PhobGCC/PhobGCCv2-HW/PCB/Models/PhobGCC_test.step

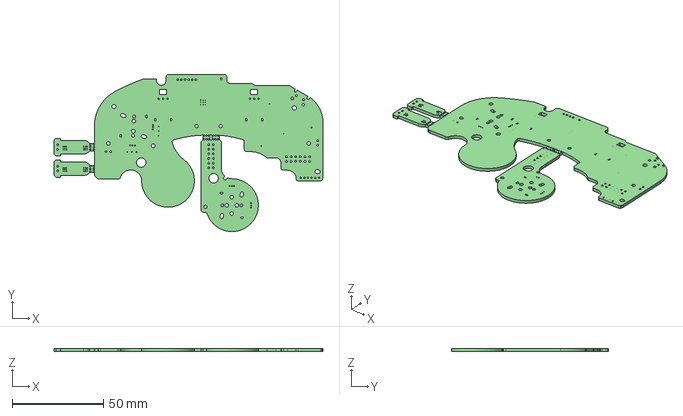
[picture p1: CAD file, 2022-11-16]
PCB/Models/PhobGCC_test.step
147.6 x 86.2 x 1.60 mm
