PhobGCC/PhobGCCv2-HW/PCB/Models/RP2040_QFN_PACKAGE.STEP

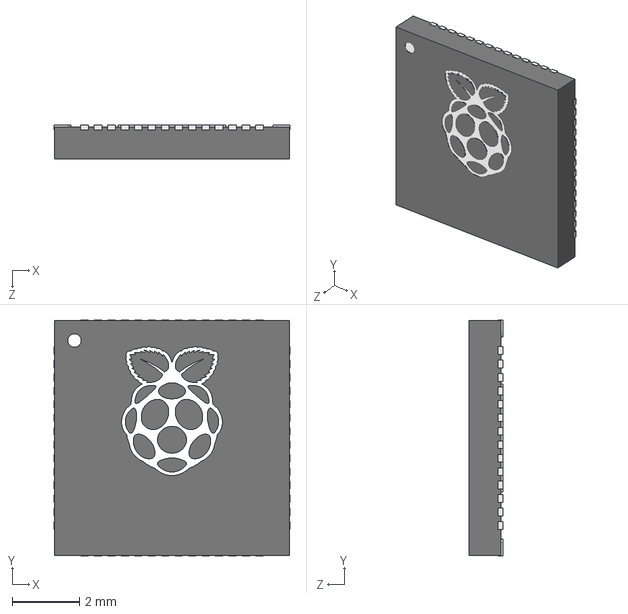
[picture p2: CAD file, 2022-11-16]
PCB/Models/RP2040_QFN_PACKAGE.STEP
7.02 x 7.02 x 1.00 mm
