PhobGCC/PhobGCCv2-HW/PCB/Models/FH34SRJ-12S-0.5SH.stp

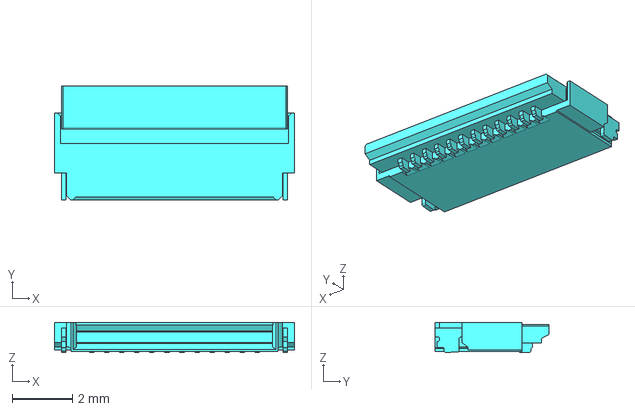
[picture p3: CAD file, 2022-11-16]
PCB/Models/FH34SRJ-12S-0.5SH.stp
8.00 x 3.80 x 1.00 mm
