PhobGCC/PhobGCCv2-HW/PCB/Models/SOIC_128JVSIQ_WIN.step

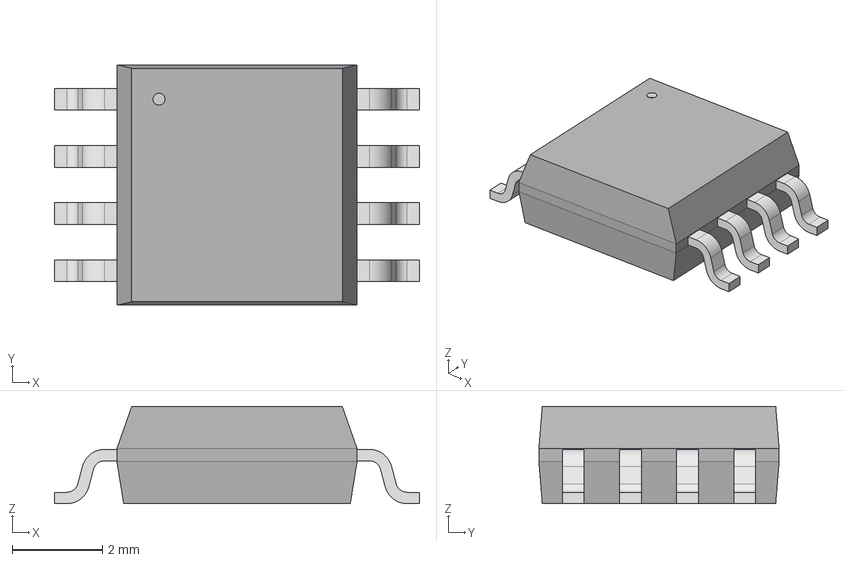
[picture p4: CAD file, 2022-11-16]
PCB/Models/SOIC_128JVSIQ_WIN.step
8.10 x 5.33 x 2.16 mm
