PhobGCC/PhobGCCv2-HW/PCB/Models/TS-1187A-B-A-B--3DModel-STEP-56544.STEP

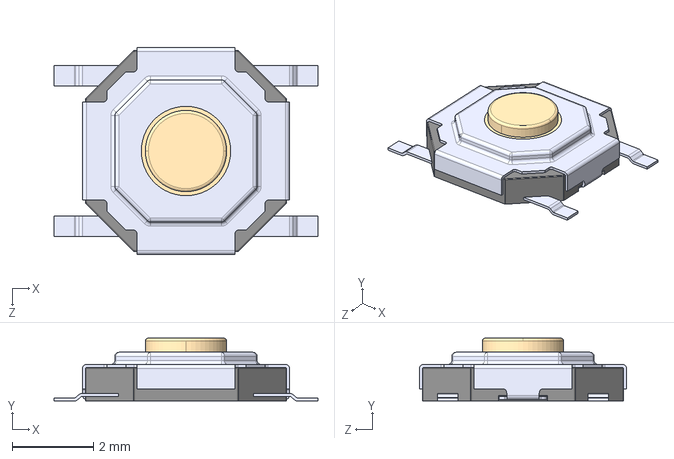
[picture p5: CAD file, 2022-11-16]
PCB/Models/TS-1187A-B-A-B--3DModel-STEP-56544.STEP
6.50 x 1.55 x 5.10 mm
