PhobGCC/PhobGCCv2-HW/PCB/Models/10118194c.stp

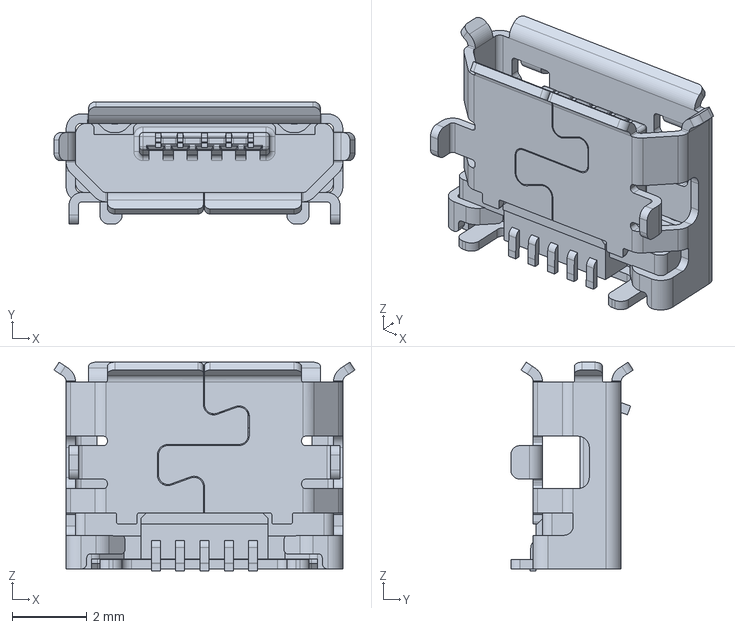
[picture p6: CAD file, 2022-11-16]
PCB/Models/10118194c.stp
8.05 x 3.27 x 5.58 mm
