PhobGCC/PhobGCCv2-HW/(list of files, cad)

Other CAD files:
PCB/Models/10118194C.igs
PCB/Models/FH34SRJ-12S-0.5SH.igs
