PhobGCC/PhobGCCv2-HW/(commit log)

2022-11-16 Initial PhobGCC v2.0 Commit
    [10118194C.igs, 10118194c.stp, FH34SRJ-12S-0.5SH.igs, FH34SRJ-12S-0.5SH.stp, PhobGCC_2_0_0_proto_1.kicad_pcb, PhobGCC_2_0_0_proto_1.kicad_sch, PhobGCC_test.step, RP2040_QFN_PACKAGE.STEP]
2022-12-08 expand clearance between pads and fill
    [PhobGCC_2_0_0_proto_1.kicad_pcb]
2022-12-11 functional changes for 2.0.1
    [PhobGCC_2_0_0_proto_1.kicad_pcb, PhobGCC_2_0_0_proto_1.kicad_sch]
2022-12-11 z changes (u shaped, elongation) and small cleanup
    [PhobGCC_2_0_0_proto_1.kicad_pcb, PhobGCC_2_0_0_proto_1.kicad_sch]
2022-12-11 silkscreen and other small changes
    [PhobGCC_2_0_0_proto_1.kicad_pcb]
2022-12-11 remove phobvision ghost
    [PhobGCC_2_0_0_proto_1.kicad_pcb]
2022-12-12 2.0.2 changes
    [PhobGCC_2_0_0_proto_1.kicad_pcb]
2022-12-12 move phobvision text
    [PhobGCC_2_0_0_proto_1.kicad_pcb]
2022-12-12 move backside ghost
    [PhobGCC_2_0_0_proto_1.kicad_pcb]
2022-12-14 dpad button footprint elongation
    [PhobGCC_2_0_0_proto_1.kicad_pcb]
2022-12-20 starting pad changes for 2.0.3
    [PhobGCC_2_0_0_proto_1.kicad_pcb, PhobGCC_2_0_0_proto_1.kicad_sch]
2022-12-20 add trigger paddles
    [TriggerBoard.kicad_pcb, TriggerBoard.kicad_sch]
2022-12-21 add keepout rule to dpad
    [PhobGCC_2_0_0_proto_1.kicad_pcb]
2022-12-22 add base triggerboard
    [TriggerBoard.kicad_pcb, TriggerBoard.kicad_sch]
2022-12-22 spiky trigger paddles
    [TriggerBoard.kicad_pcb]
2022-12-22 add footprints for trigger pads
2022-12-22 remove unneeded layers in trigger paddles
    [PhobGCC_2_0_0_proto_1.kicad_pcb, TriggerBoard.kicad_pcb]
2022-12-23 rotate z jst and lengthen c board breakaway for z jst clearance
    [PhobGCC_2_0_0_proto_1.kicad_pcb, TriggerBoard.kicad_pcb]
2023-01-12 abxy pad changes
    [PhobGCC_2_0_0_proto_1.kicad_pcb, PhobGCC_2_0_0_proto_1.kicad_sch]
2023-01-12 trigger board silkscreen update
    [TriggerBoard.kicad_pcb]
2023-01-12 rotate c stick logo
    [PhobGCC_2_0_0_proto_1.kicad_pcb]
2023-01-14 abxy pad center line thicker, round out dpad arch
    [PhobGCC_2_0_0_proto_1.kicad_pcb]
2023-01-14 'blue wire on left for oem cables'
    [PhobGCC_2_0_0_proto_1.kicad_pcb]
2023-01-14 oly u usb data pin position
    [PhobGCC_2_0_0_proto_1.kicad_pcb]
2023-01-14 ground track coverage
    [PhobGCC_2_0_0_proto_1.kicad_pcb]
2023-01-16 fix oly u by 1mm
    [PhobGCC_2_0_0_proto_1.kicad_pcb]
2023-01-16 actually line up olyu for real (for real)
    [PhobGCC_2_0_0_proto_1.kicad_pcb]
2023-01-20 move L pads for JST clearance
    [PhobGCC_2_0_0_proto_1.kicad_pcb]
2023-01-25 keepout around cstick header
    [PhobGCC_2_0_0_proto_1.kicad_pcb]
2023-01-25 bigger keepout around cstick header
    [PhobGCC_2_0_0_proto_1.kicad_pcb]
2023-02-11 ESD protection
    Added 100k resistor between sgnd and gnd of usb connector
    Added USBLC6 to protect USB data lines
    Added TVS diodes to GCD and 3.3 lines
    Added 47uF bulk capacitor
    [PhobGCC_2_0_0_proto_1.kicad_pcb, PhobGCC_2_0_0_proto_1.kicad_sch]
2023-02-13 Isolate 47uF capacitor
    Isolates the 47uF capacitor with a diode. Matches the voltage drop so there is a consistent power level across USB or GC cable. Prevents inrush current on USB power.
    [PhobGCC_2_0_0_proto_1.kicad_pcb, PhobGCC_2_0_0_proto_1.kicad_sch]
2023-02-13 Inset components to account for rib
    [PhobGCC_2_0_0_proto_1.kicad_pcb]
2023-02-15 Move C16 in 1mm
    [PhobGCC_2_0_0_proto_1.kicad_pcb]
2023-02-15 move 3.3v cap inboard of schottky
    [PhobGCC_2_0_0_proto_1.kicad_pcb, PhobGCC_2_0_0_proto_1.kicad_sch]
2023-02-15 small aesthetic tweak to traces
    [PhobGCC_2_0_0_proto_1.kicad_pcb]
2023-02-16 reduce paste applied to rp2040 pins
    [PhobGCC_2_0_0_proto_1.kicad_pcb]
2023-02-24 fix DRC and silkscreen
    [PhobGCC_2_0_0_proto_1.kicad_pcb]
2023-02-25 remove rando silkscreen line
    [PhobGCC_2_0_0_proto_1.kicad_pcb]
2023-02-27 make z jumper not go through z button trace
    [PhobGCC_2_0_0_proto_1.kicad_pcb]
2023-02-27 make z jumper not go through z button trace (for real)
    [PhobGCC_2_0_0_proto_1.kicad_pcb]
2023-03-18 solder pad absolute clearance back to 0
    [PhobGCC_2_0_0_proto_1.kicad_pcb]
2023-03-18 thick olyu usb lines, 2.0.4 version
    [PhobGCC_2_0_0_proto_1.kicad_pcb]
2023-04-01 replace discrete diodes with usblc6
    [PhobGCC_2_0_0_proto_1.kicad_pcb, PhobGCC_2_0_0_proto_1.kicad_sch]
2023-04-01 add lcsc part numbers
    [PhobGCC_2_0_0_proto_1.kicad_sch]
2023-04-01 minor tweaking of routing
    [PhobGCC_2_0_0_proto_1.kicad_pcb]
2023-04-01 slight c-stick wiring tweaks for aesthetics
    [PhobGCC_2_0_0_proto_1.kicad_pcb]
2023-04-01 BOM Generation
    [PhobGCC_2_0_0_proto_1.kicad_pcb]
2023-04-01 update pcb part designations
    [PhobGCC_2_0_0_proto_1.kicad_pcb]
2023-04-01 fix drc errors
    [PhobGCC_2_0_0_proto_1.kicad_pcb]
2023-04-01 move usb lines to better connect 3.3v plane
    [PhobGCC_2_0_0_proto_1.kicad_pcb]
2023-04-01 Bom Changes 2
    [PhobGCC_2_0_0_proto_1.kicad_pcb]
2023-04-18 revert pads to 2.0.2, rev to 2.0.5
    [PhobGCC_2_0_0_proto_1.kicad_pcb]
