PhobGCC/PhobGCCv2-HW/(notices)

Notices in the files:
PCB/KiCAD/PhobGCC_2_0_0_proto_1.kicad_pcb:
CERN-OHL-S v2
